Dkhanas/bc250-power-controller/pcb/kicad/bc250_power.kicad_pcb

## KiCad design pcb/kicad/bc250_power.kicad_pcb (2026-11-06)

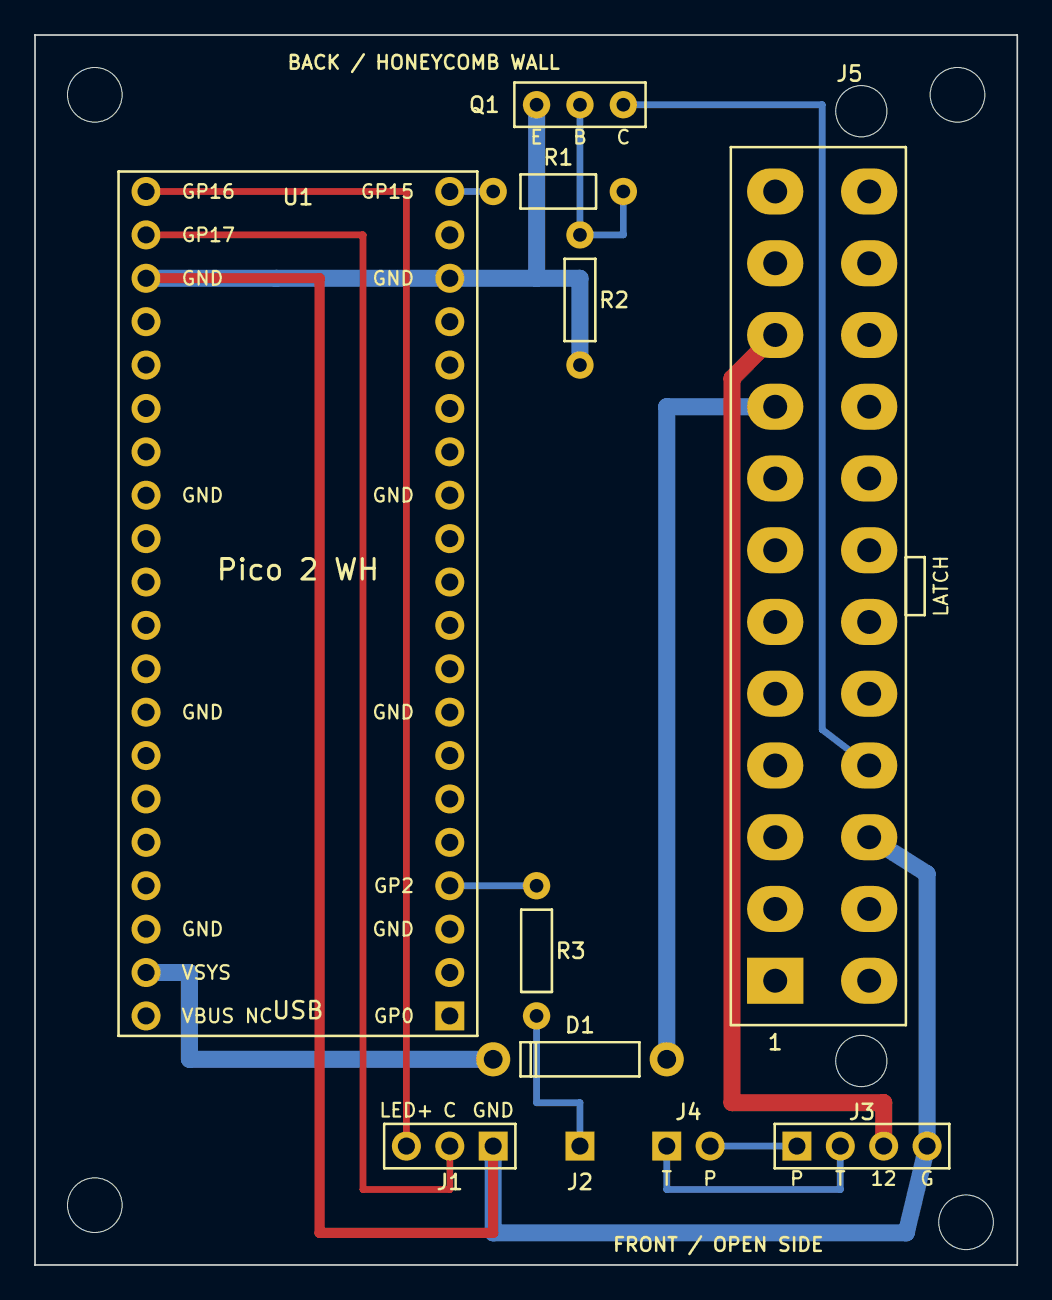
[picture p6: board bc250_power.kicad_pcb from above]

Board: 2 copper layers, 57.5 x 72.0 mm, 15 parts (0 on the bottom side), 13 nets.

Parts:
D1: 1N5819; D1_1N5819
H1: M3; H1_M3
H2: M3; H2_M3
H3: M3; H3_M3
H4: M3; H4_M3
J1: BUTTON; J1_BUTTON
J2: TPM9; J2_TPM9
J3: FAN2; J3_FAN2
J4: J4003; J4_J4003
J5: ATX24; J5_ATX24
Q1: 2N2222; Q1_2N2222
R1: 1k; R1_1k
R2: 10k; R2_10k
R3: 220R; R3_220R
U1: Pico2WH; U1_Pico2WH

Connections:
5VSB: D1.A, J5.9
+12V: J3.3, J5.10
BTN: J1.2, U1.22
FAN_PWM: J3.1, J4.2
FAN_TACH: J3.2, J4.1
GND: J1.1, J3.4, J5.15, Q1.E, R2.2, U1.18, U1.23
GP2: R3.1, U1.4
GP15: R1.1, U1.20
LED+: J1.3, U1.21
PS_ON: J5.16, Q1.C
Q1_BASE: Q1.B, R1.2, R2.1
TPM9: J2.1, R3.2
VSYS: D1.K, U1.39
