Dkhanas/bc250-power-controller/firmware/src/lwipopts.h

// lwIP settings for the BC-250 power controller (v8: Wi-Fi web page + MQTT + mDNS)
#ifndef _LWIPOPTS_H
#define _LWIPOPTS_H

#define NO_SYS                      1      // pico_cyw43_arch_lwip_threadsafe_background
#define LWIP_SOCKET                 0
#define LWIP_NETCONN                0
#define MEM_LIBC_MALLOC             0
#define MEM_ALIGNMENT               4
#define MEM_SIZE                    16000
#define MEMP_NUM_TCP_SEG            32
#define MEMP_NUM_ARP_QUEUE          10
#define MEMP_NUM_TCP_PCB            8
#define PBUF_POOL_SIZE              24
#define LWIP_ARP                    1
#define LWIP_ETHERNET               1
#define LWIP_ICMP                   1
#define LWIP_RAW                    1
#define TCP_MSS                     1460
#define TCP_WND                     (8 * TCP_MSS)
#define TCP_SND_BUF                 (8 * TCP_MSS)
#define TCP_SND_QUEUELEN            ((4 * (TCP_SND_BUF) + (TCP_MSS - 1)) / (TCP_MSS))
#define LWIP_NETIF_STATUS_CALLBACK  1
#define LWIP_NETIF_LINK_CALLBACK    1
#define LWIP_NETIF_HOSTNAME         1
#define LWIP_NETIF_TX_SINGLE_PBUF   1
#define LWIP_CHKSUM_ALGORITHM       3
#define LWIP_DHCP                   1
#define LWIP_IPV4                   1
#define LWIP_TCP                    1
#define LWIP_UDP                    1
#define LWIP_DNS                    1
#define LWIP_TCP_KEEPALIVE          1
#define DHCP_DOES_ARP_CHECK         0
#define LWIP_DHCP_DOES_ACD_CHECK    0

// mDNS: http://bc250.local
#define LWIP_IGMP                   1
#define LWIP_MDNS_RESPONDER         1
#define LWIP_NUM_NETIF_CLIENT_DATA  1
#define MDNS_MAX_SERVICES           1
#define MEMP_NUM_SYS_TIMEOUT        (LWIP_NUM_SYS_TIMEOUT_INTERNAL + 8)

// MQTT (Home Assistant discovery messages are ~500 bytes)
#define MQTT_OUTPUT_RINGBUF_SIZE    1536
#define MQTT_VAR_HEADER_BUFFER_LEN  256
#define MQTT_REQ_MAX_IN_FLIGHT      8

#define MEM_STATS                   0
#define SYS_STATS                   0
#define MEMP_STATS                  0
#define LINK_STATS                  0
#define LWIP_STATS                  0
#define LWIP_STATS_DISPLAY          0

#endif
