Dkhanas/bc250-power-controller/(commit log)

2026-10-20 BC-250 power controller: firmware v4, PCB v9, perfboard, BOM
    - firmware/: Pico 2 W firmware v4 (Bluetooth self-healing) + ready-to-flash uf2
    - pcb/: PCB v9 (corrected ATX header) - KiCad project, Gerbers, images
    - perfboard/: test board map v16 with layout drawings
    - docs/build-plan.md, bom.csv
    Claude-Session: https://claude.ai/code/session_01VyRMRioZQihzu5HuGHHPt4
    [bc250_power.kicad_pcb, bom.csv]
2026-10-20 BC-250 power controller: firmware v4, PCB v9, perfboard, BOM
    [bc250_power.kicad_pcb, bom.csv]
2026-11-06 Firmware v7: pairing window (hold button 2 s)
    - Controllers in pairing mode are ignored unless the pairing window is open,
    so pairing a controller with a phone/PC is no longer taken over by the Pico
    - Hold the case button 2 s and release to open it for 60 s (LED double-blinks);
    closes as soon as the new controller is paired; log port command 'p' too
    - Bonded BLE controllers (e.g. Xbox) still reconnect via advertising
    [bt_bridge.c, bt_bridge.h, config.h, log.c, main.c]
2026-11-06 v8: Wi-Fi page, battery warning; firmware with/without Home Assistant
2026-11-06 PCB v11: ATX pin 1 at back, spaced front headers
    Claude-Session: https://claude.ai/code/session_01WPtG9yLGdJqMrRyDDpCh4f
    [bc250_power.kicad_pcb, bom.csv]
2026-11-06 PCB v11: ATX pin 1 at back, spaced front headers
2026-11-06 PCB v12: correct ATX pin order, spaced headers, pinout docs
    - ATX 24-pin back to v9 order (pin 1 at the front, latch to the wall),
    matching the 5VSB position measured with the real PSU cable on a v8 board.
    v10/v11 were mirrored (12 V on GND) - removed the v11 Gerbers.
    - One empty hole between J1, J2, J4 and J3 on the front row.
    - Q1 and R2 moved left: >= 5.5 mm clearance to the ATX connector body.
    - Bottom-right screw hole moved so an M3 head clears J3.
    - New docs/pinout.md (connector drawings); README, BOM, build plan and
    changelog updated for v12.
    [bc250_power.kicad_pcb, bom.csv]
